MabrozKhan/esp32-quadrocopter/hardware/cad/drone_frame.3mf

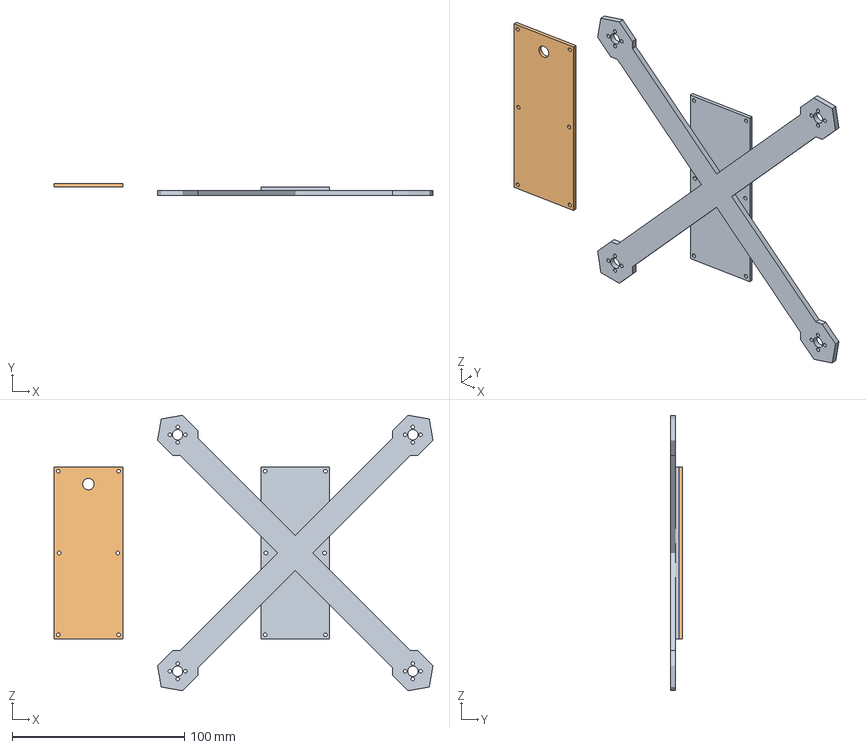
[picture p17: CAD file, 2026-10-05]
hardware/cad/drone_frame.3mf
219.9 x 7.00 x 159.9 mm
Körper1
Körper5
