MabrozKhan/esp32-quadrocopter/hardware/cad/remote_housing.3mf

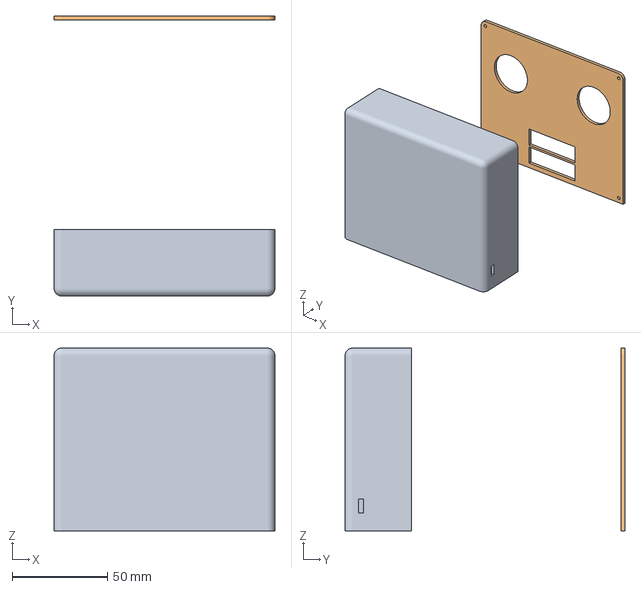
[picture p18: CAD file, 2026-10-05]
hardware/cad/remote_housing.3mf
116.0 x 147.0 x 96.0 mm
Körper1
Körper3
