MabrozKhan/esp32-quadrocopter/(commit log)

2026-10-05 Projekt aufsetzen: Flugsteuerung, Fernsteuerung, CAD und Bericht
    Erster Stand des Projektseminar-Projekts: ESP32-Quadrocopter mit
    selbstprogrammierter Flugsteuerung und eigener Fernsteuerung ueber ESP-NOW.
    Enthaelt die aktuellen Sketches, aeltere Programmstaende im Archiv, die
    3D-Modelle und den abgegebenen Projektbericht.
    [Controller 3D-Modell.3mf, Drohne 3D-Modell.3mf]
2026-10-05 .gitattributes ergaenzen
    Legt die Zeilenenden-Behandlung fest, damit Git beim Wechsel zwischen
    Windows und Arduino nicht mehr warnt, und schuetzt 3MF-, PDF- und
    Bilddateien ausdruecklich vor Textnormalisierung.
2026-10-23 Clean up repo and translate to English
    New folder structure (firmware, hardware, docs), English README with photos, design notes and debugging stories, code comments in English without the old fix log, archive folder removed, MIT license added. No change to the control logic.
    [drone_frame.3mf, remote_housing.3mf]
